yyii-site/smu-mini-ad5522/Document/README_CN.md

## AD5522 通讯

SPI 外设通讯设置

AD5522 write

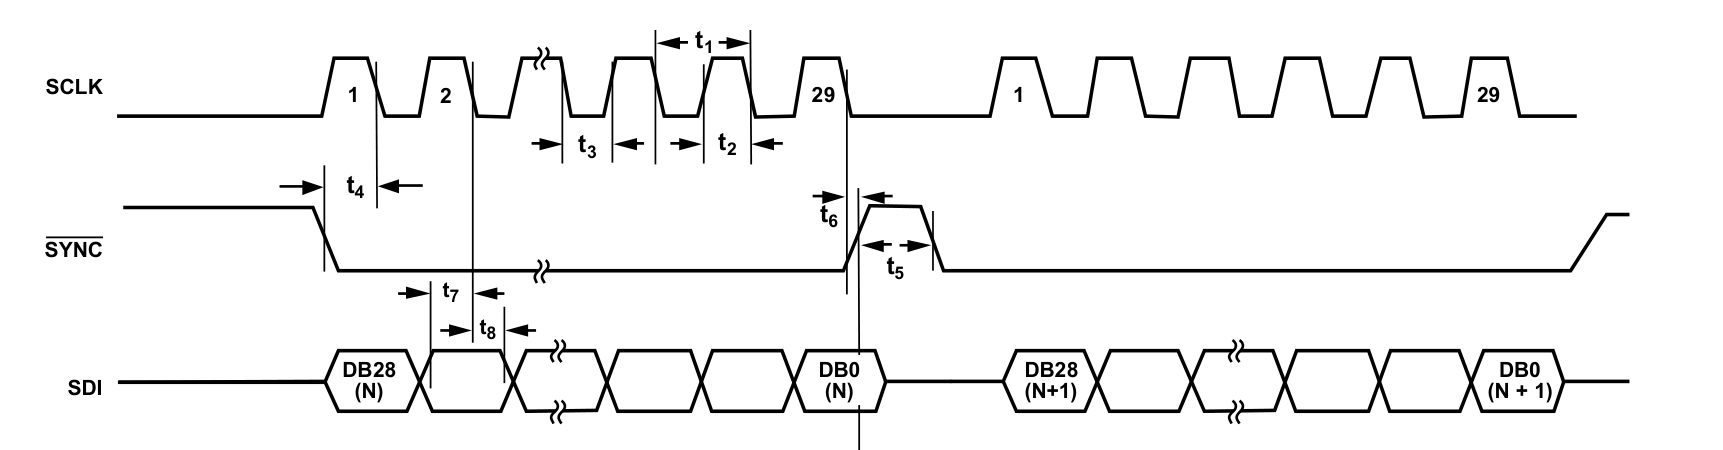
[picture p4: Document/img/spi_write.png]
spi_write


AD5522 read

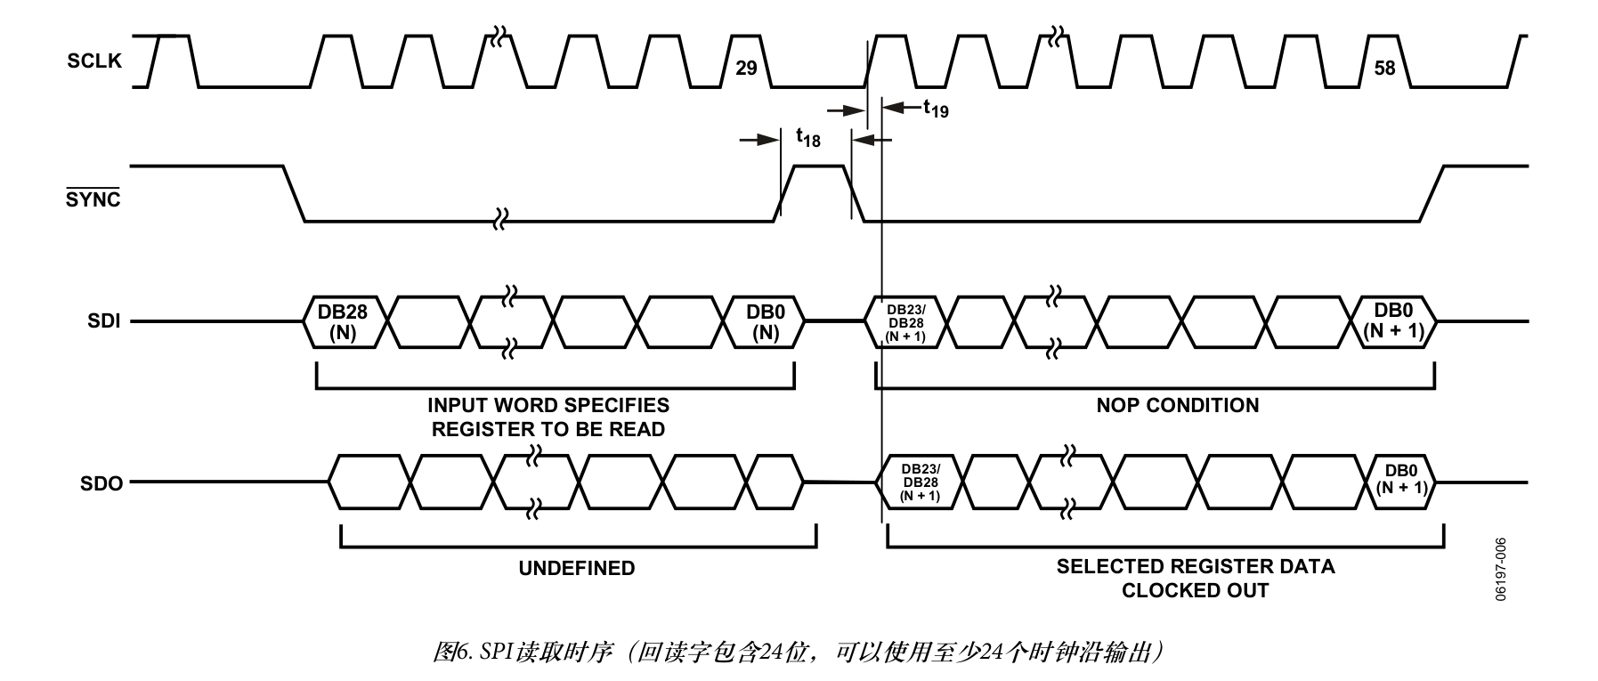
[picture p5: Document/img/spi_read.png]
spi_read


SPI Mode

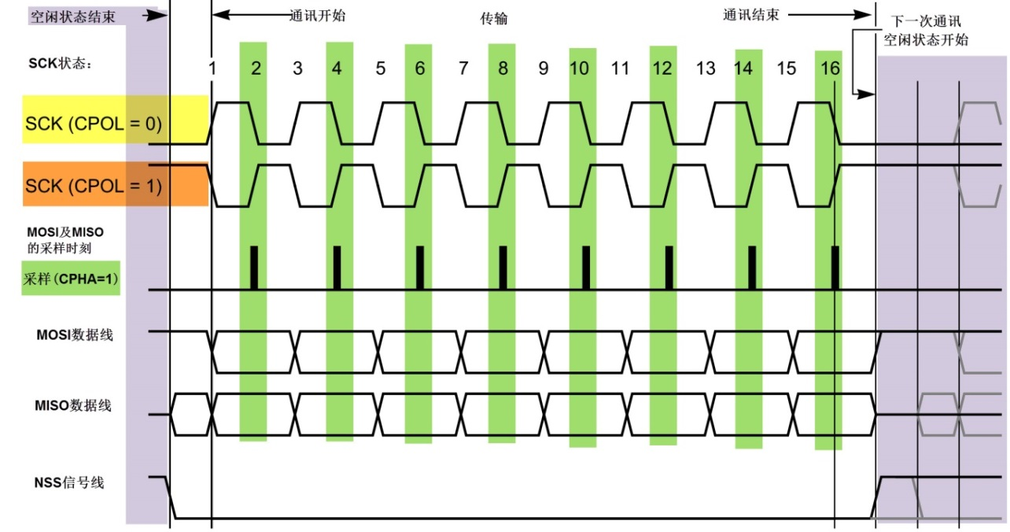
[picture p6: Document/img/spi_mode.png]
spi_mode


spi_mode_sheet

https://doc.embedfire.com/mcu/stm32/f103badao/std/zh/latest/book/SPI.html

根据时序要求可知，spi外设参数为

CPOL = 0

CPHA = 1

FIRSTBIT_MSB

这是STM32F103 SPI 的设置结果，其中通讯速率可自由修改。

```cpp
  hspi1.Instance = SPI1;
  hspi1.Init.Mode = SPI_MODE_MASTER;
  hspi1.Init.Direction = SPI_DIRECTION_2LINES;
  hspi1.Init.DataSize = SPI_DATASIZE_8BIT;
  hspi1.Init.CLKPolarity = SPI_POLARITY_LOW;
  hspi1.Init.CLKPhase = SPI_PHASE_2EDGE;
  hspi1.Init.NSS = SPI_NSS_SOFT;
  hspi1.Init.BaudRatePrescaler = SPI_BAUDRATEPRESCALER_16;
  hspi1.Init.FirstBit = SPI_FIRSTBIT_MSB;
  hspi1.Init.TIMode = SPI_TIMODE_DISABLE;
  hspi1.Init.CRCCalculation = SPI_CRCCALCULATION_DISABLE;
  hspi1.Init.CRCPolynomial = 10;
```

寄存器写函数为：

```cpp
// 大小端转换
uint32_t toLittleEndian(uint32_t value) {
    return ((value >> 24) & 0x000000FF) | // 移动到低位
           ((value >> 8) & 0x0000FF00) |  // 移动到中间
           ((value << 8) & 0x00FF0000) |  // 移动到高位
           ((value << 24) & 0xFF000000);  // 移动到最高位
}

int AD5522_WriteReg(handle_AD5522* h,__IO uint32_t cmd)
{
	// cmd = cmd<<3; 不需要移位
	uint32_t cmd_l = toLittleEndian(cmd);
	HAL_GPIO_WritePin(SMU_CS_GPIO_Port,SMU_CS_Pin,0);
	SMU_SPI_CS_DELAY
	int resp = HAL_SPI_Transmit(h->hspi,(uint8_t*)&cmd_l,4,1000);
	SMU_SPI_CS_DELAY
	HAL_GPIO_WritePin(SMU_CS_GPIO_Port,SMU_CS_Pin,1);
	return resp;
}

int AD5522_ReadReg(handle_AD5522* h,__IO uint32_t cmd, __IO uint32_t* rst)
{
	uint32_t cmd_l = toLittleEndian(cmd);
	uint32_t cmd_nop = toLittleEndian(0x00FFFFFF); // NOP
	uint32_t rst_l = 0;
	HAL_GPIO_WritePin(SMU_CS_GPIO_Port,SMU_CS_Pin,0);
	SMU_SPI_CS_DELAY
	HAL_SPI_Transmit(h->hspi,(uint8_t*)&cmd_l,4,1000);
	SMU_SPI_CS_DELAY
	HAL_GPIO_WritePin(SMU_CS_GPIO_Port,SMU_CS_Pin,1);
	SMU_SPI_CS_DELAY
	HAL_GPIO_WritePin(SMU_CS_GPIO_Port,SMU_CS_Pin,0);
	SMU_SPI_CS_DELAY
	int resp=HAL_SPI_TransmitReceive(h->hspi,(uint8_t*)&cmd_nop,(uint8_t*)&rst_l,4,1000);
	SMU_SPI_CS_DELAY
	HAL_GPIO_WritePin(SMU_CS_GPIO_Port,SMU_CS_Pin,1);

	*rst = toLittleEndian(rst_l);

	*rst=*rst>>8; //shift 32bit SPI to 24 bit readout
	return resp;
}
```

说明：

1.因为将 `hspi1.Init.DataSize = SPI_DATASIZE_8BIT;` 故需要做大小端转换。例如 cmd 为 0x12345678 为了让函数 `HAL_SPI_Transmit(h->hspi,(uint8_t*)&cmd_l,4,1000);` 按 12 34 56 78 的顺序输出，需要将 cmd_l 的内容调整为 78 56 34 12。

2.(Rev. F | Page 42 of 64)处有这样一段说明：`移位寄存器可以接受更长的字（例如，32位字），按SYNC帧同步，但数据应始终位于第29个LSB位。` 一开始我理解为需要将cmd右移三位即 spi 输出的第一个位为读写控制位。实际测试并不需要这样操作。

3. 写操作，NOP 可以是 0x00FFFFFF HAL_SPI_TransmitReceive 写入 4个字节。或者 0xFFFFFF HAL_SPI_TransmitReceive 写入 3个字节

下图是逻辑分析仪采集 PMU_DACREG_ADDR_FIN_5UA_M 寄存器读取的过程。

```cpp
AD5522_WriteReg(&h_PMU,PMU_CH_0|PMU_DACREG_ADDR_FIN_5UA_M|0x0123);

uint32_t buf=0;
AD5522_ReadReg(&h_PMU, PMU_REG_RD|PMU_CH_0|PMU_DACREG_ADDR_FIN_5UA_M, &buf);
```

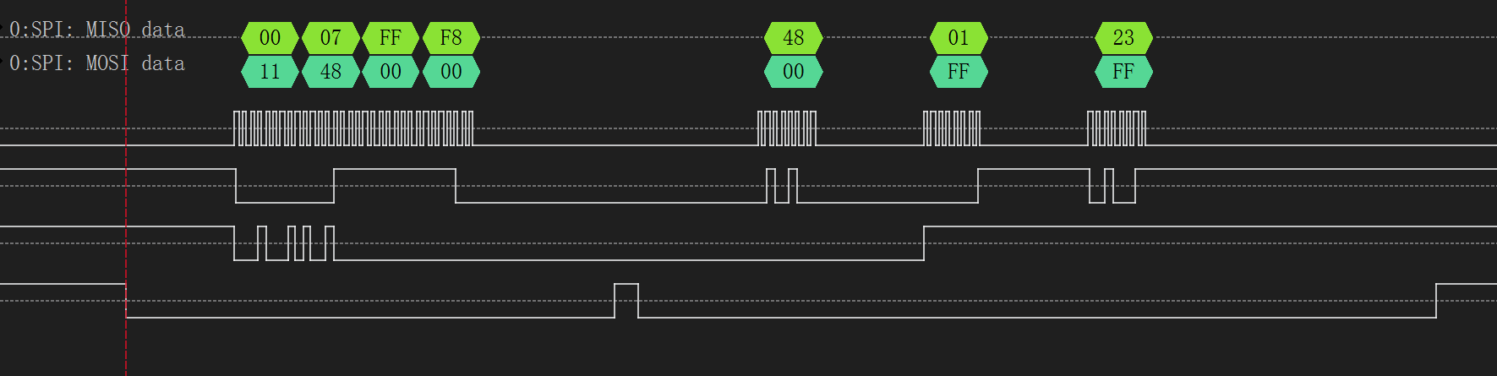
[picture p7: Document/img/dsview.png]
DSView


## AD7190 通讯

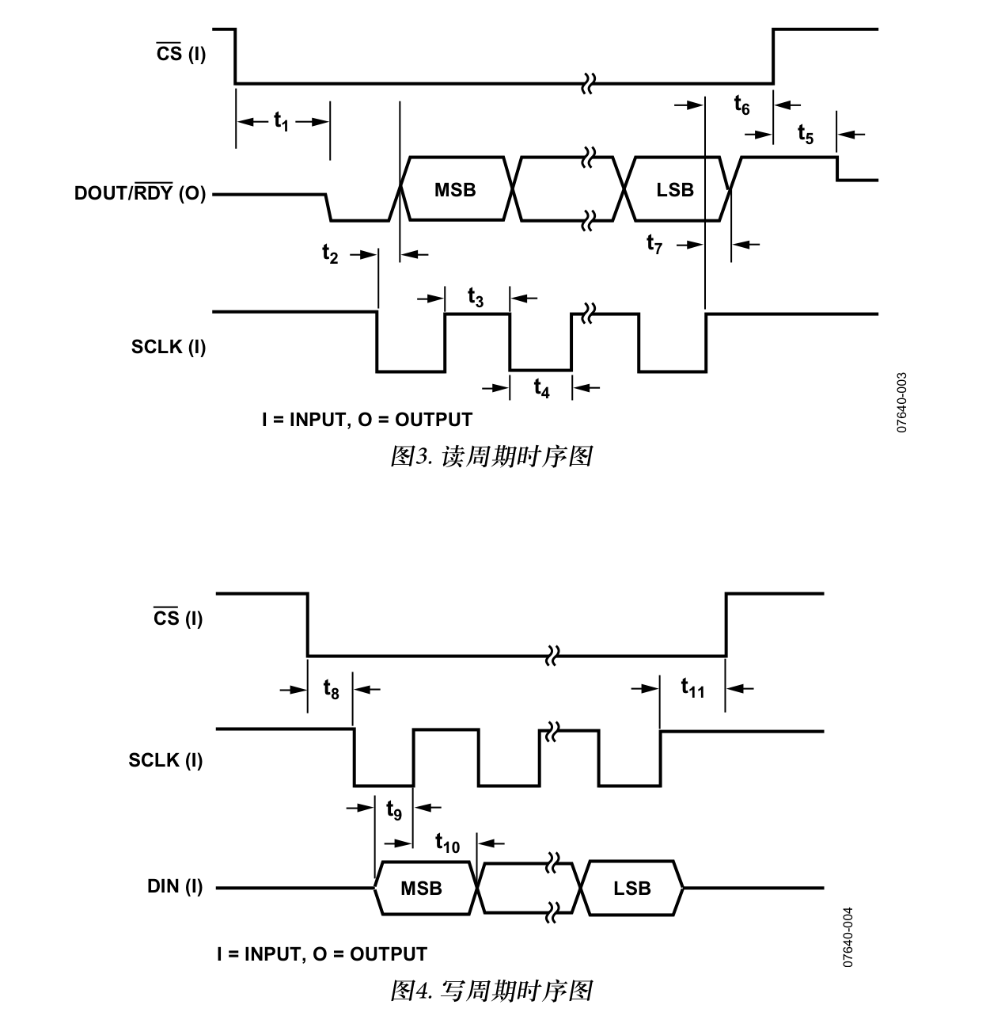
[picture p8: Document/img/spi_7190_rxtx.png]
spi_7190_rxtx


时序和 AD5522 不太一样，应该是：

CPOL = 1

CPHA = 1

故需要单独写一个 SPI 外设的初始化函数，仅修改 MX_SPI1_Init 中的：

```c
hspi1.Init.CLKPolarity = SPI_POLARITY_HIGH;
```

SPI CLK 速率最高: 周期(100ns + 100ns) 频率(5MHz)

当前频率 4.5Mhz

## 同时与 AD5522 和 AD7190 通讯

`AD7190_SPI1_Init();` 函数完成后 sclk 的电平还是为低，此时并不能直接和 AD7190 通讯，需要发送一次数据将 sclk 的电平转为高以后再去和 AD7190 通讯

```c
// 将 clk 的电平切换到 High
void SPI_Send_Nop() {
  const uint8_t nop_data = 0;
  HAL_SPI_Transmit(&hspi1, &nop_data, 1, 1000);
}
```
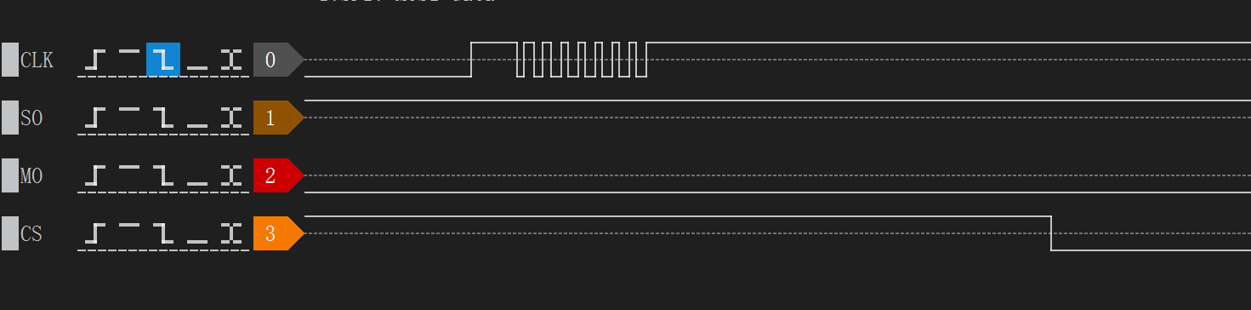
[picture p9: Document/img/AD7190_SPI1_Init.png]
AD7190_SPI1_Init


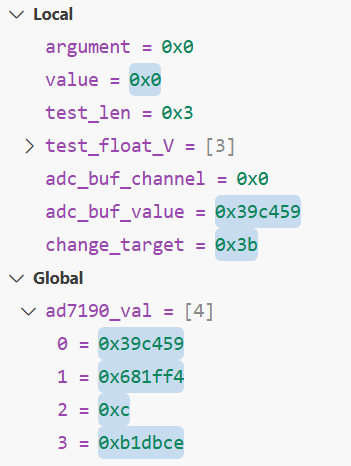
[picture p10: Document/img/ad7190_AutoContinueMode_read.png]
ad7190_AutoContinueMode_read


## 串口 DMA 接收功能

想要使用`空闲检测`功能，则需要启用 DMA 接收中断，也要启动串口中断。

## SCPI

[STM32 + VS code + CMake 环境下串口打印浮点数](https://zhuanlan.zhihu.com/p/696691495)

`:CHANnel1:FUNCtion "HIZMV"`  字符串最后需要增加0x0A，调试软件先输入字符串，再勾选十六进制发送，此时可增加 0A结束符，最后发送。

指令发送错误的话，软件会进入断言停止进一步执行

fprintf(stderr, "ch1:func ***%s***\r\n", buffer);  // 打印字符串时会造成内存溢出。表现为 xSemaphoreGive(semaphore_scpi); 执行时 semaphore_scpi 的地址为 0x00, 进入断言

fprintf 内存溢出的原因是：调用位置在由 osThreadNew 创建的任务中，但是默认给 Task 分配的内存较小（仅512Byte），增加内存到 1024Byte 后即运行正常。 [As many people already said, sprintf is a big function. You can try to increase the stack of the task using it too. ](https://www.reddit.com/r/embedded/comments/f00iee/how_to_fix_a_sprintfcaused_hard_fault_on_stm32)

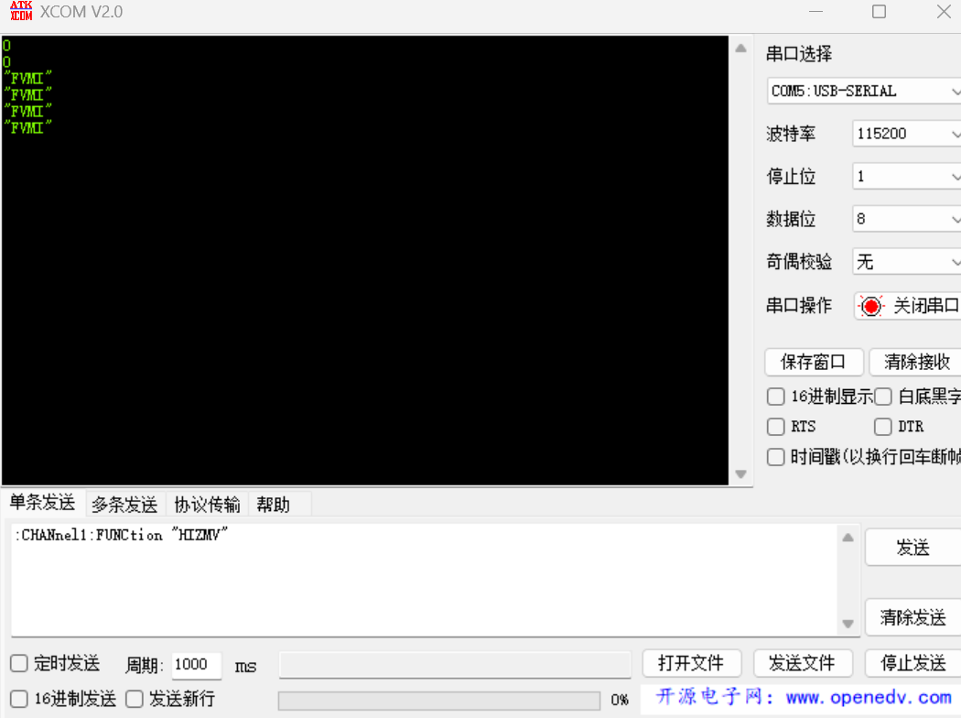
[picture p11: Document/img/SCPI_debug1.png]
SCPI_debug1


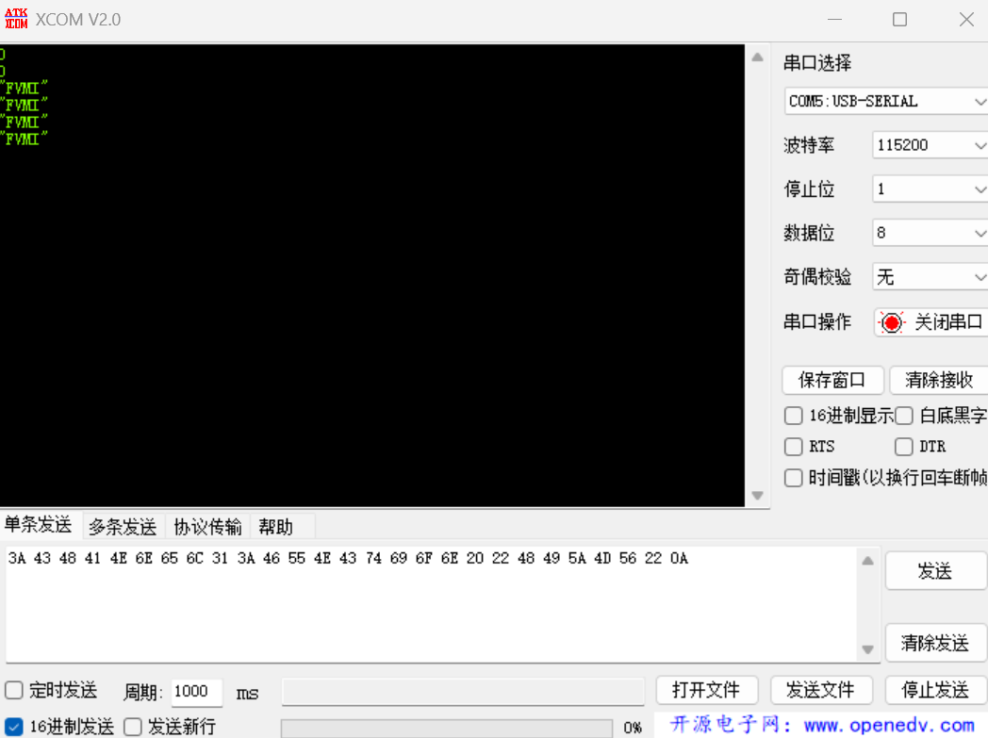
[picture p12: Document/img/SCPI_debug2.png]
SCPI_debug2
