yyii-site/smu-mini-ad5522/Document/img/cubemx_pinMap.jpg

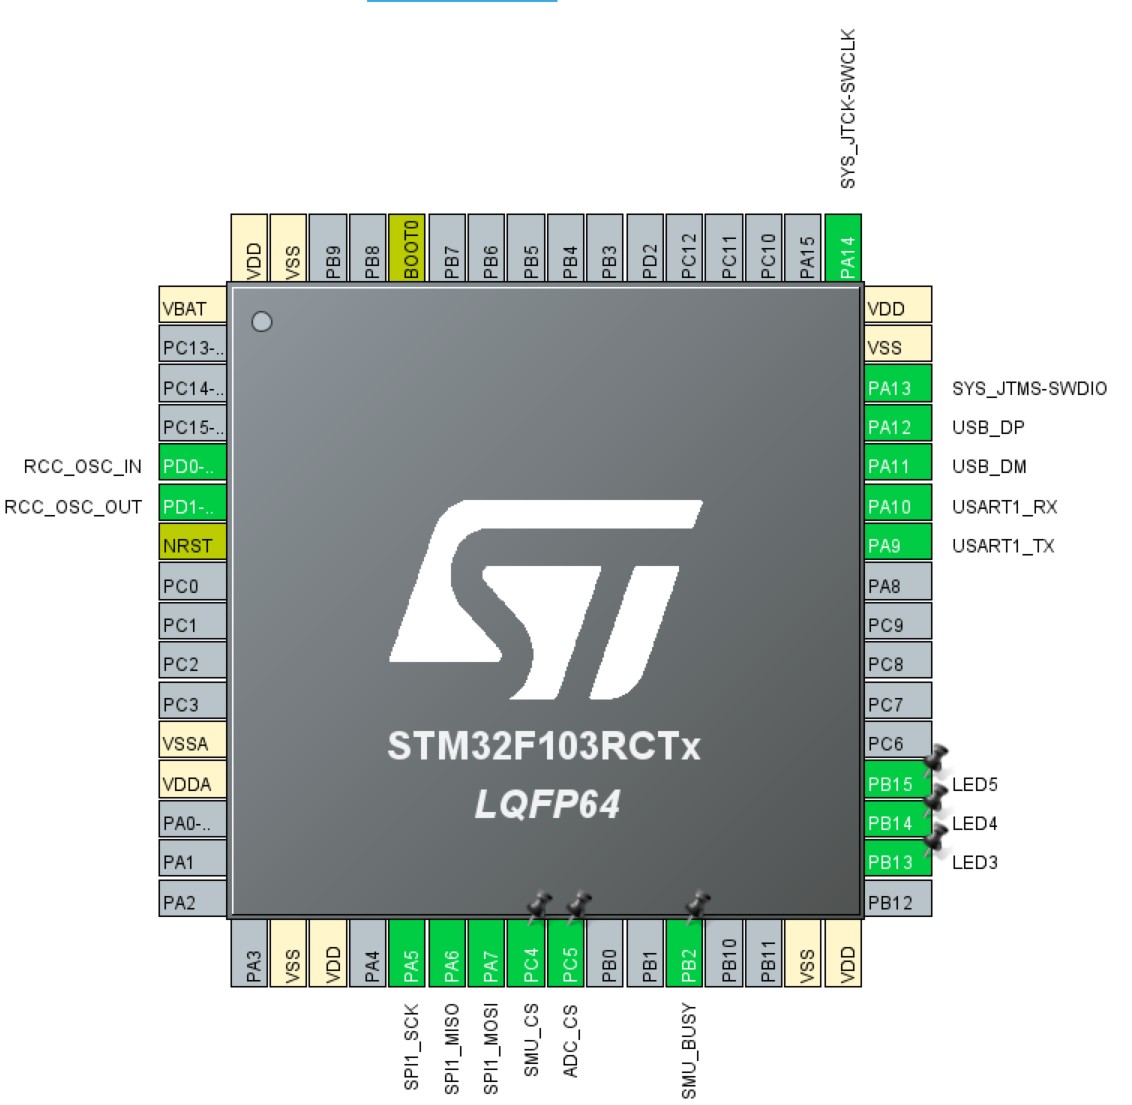
Document/img/cubemx_pinMap.jpg
