yyii-site/smu-mini-ad5522/Document/img/test_FVMI_5V.jpg

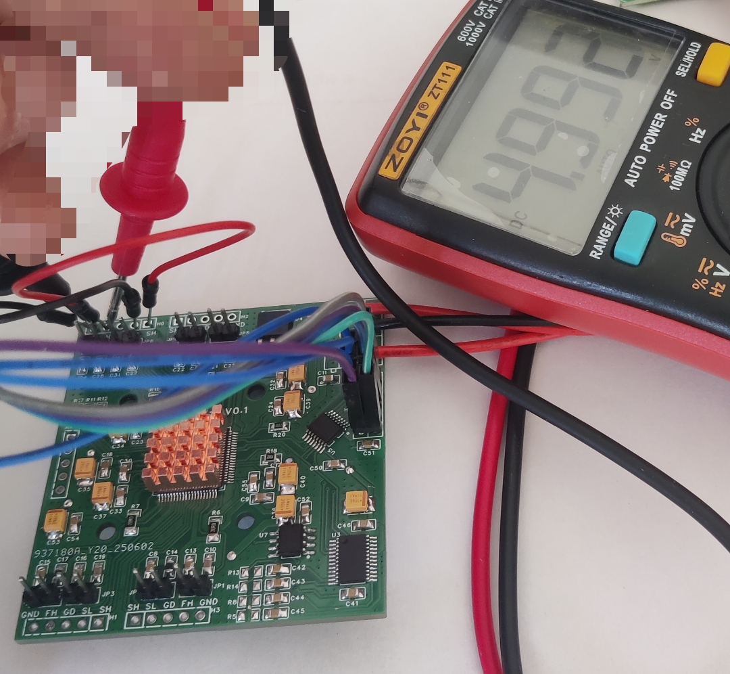
Document/img/test_FVMI_5V.jpg
