yyii-site/smu-mini-ad5522/Document/SCH_Schematic1_2025-06-07.pdf

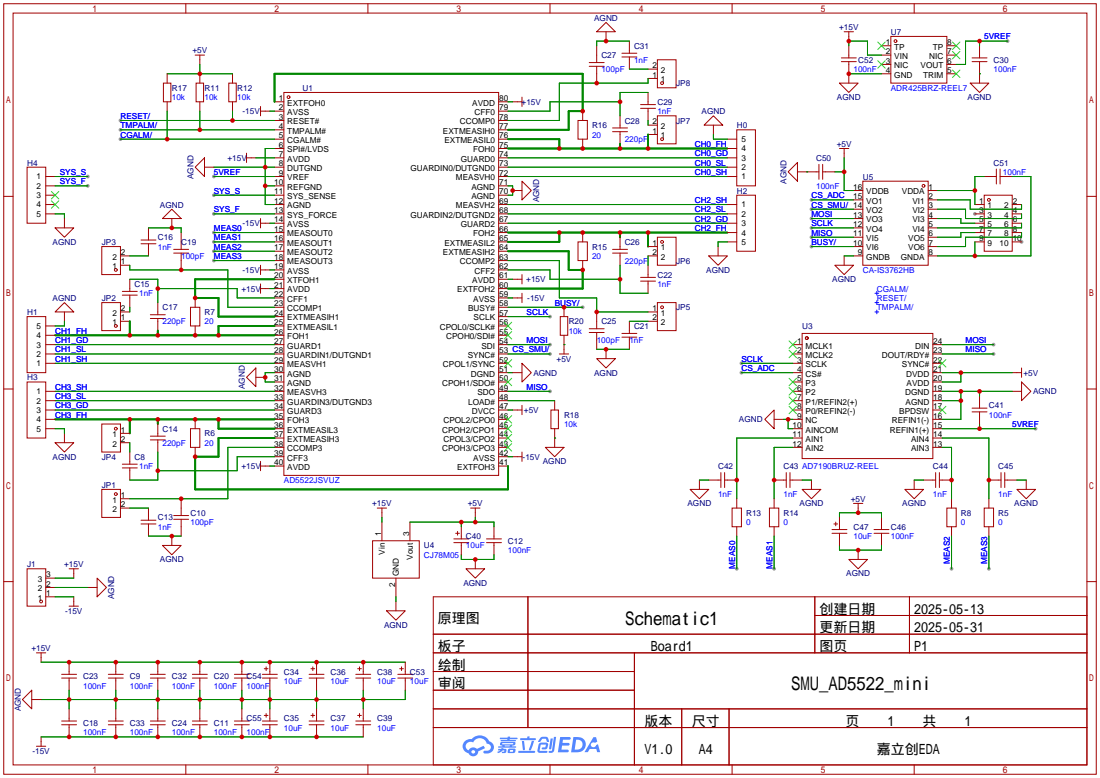
[picture p15: page 1]

原理图 | Schematic1 | 创建日期 | 2025-05-13

更新日期 | 2025-05-31

板子 | Board1 | 图页 | P1
绘制 | | SMU_AD5522_mini
审阅

V1.0 | A4 | 嘉立创EDA
