yyii-site/smu-mini-ad5522/Core/Inc/main.h

#define SMU_CS_Pin GPIO_PIN_4
#define SMU_CS_GPIO_Port GPIOC
#define ADC_CS_Pin GPIO_PIN_5
#define ADC_CS_GPIO_Port GPIOC
#define SMU_BUSY_Pin GPIO_PIN_2
#define SMU_BUSY_GPIO_Port GPIOB
#define ADC_READY_Pin GPIO_PIN_11
#define ADC_READY_GPIO_Port GPIOB
#define LED3_Pin GPIO_PIN_13
#define LED3_GPIO_Port GPIOB
#define LED4_Pin GPIO_PIN_14
#define LED4_GPIO_Port GPIOB
#define LED5_Pin GPIO_PIN_15
#define LED5_GPIO_Port GPIOB
