yyii-site/smu-mini-ad5522/(commit log)

2025-06-15 ad5522 out 5V
2025-06-23 add scpi library
    [scpi.g]
2025-06-25 printf support float (ROM 5k)
2025-10-04 SCPI 接收指令，并控制 AD5522 芯片状态
2025-10-04 Task分配的内存较小，造成调用 fprintf 时内存溢出
2025-10-10 修复由于MX_SPI1_Init函数造成AD5522参数设置出错的问题
2025-10-11 可通过上位机设置 CH0 的目标电压，读取 AD7190 的测量值
2025-10-11 增加 ch0 通道测试接线图片
2025-10-16 参考电压5V时MI_gain应为10；硬件电路中外部电流采样电阻为20ohm；AD5522校准值恢复默认；启用钳位功能；修复FunctionQ中工作模式的判断；
2025-10-21 重新建立工程，修复F12无法跳转的问题
2025-10-23 ad5522电流电阻分开为单独的通道；SCPI指令支持4个通道；
2025-10-28 修复工作模式判断位计算的bug
2025-11-03 修复恒流模式下目标电流设置的问题
2025-12-01 实现输出电压校准（暂时直接固化在程序中） 修改目标电流转DAC值计算公式
